dakota127/ctc/pictures/ctc2.jpg

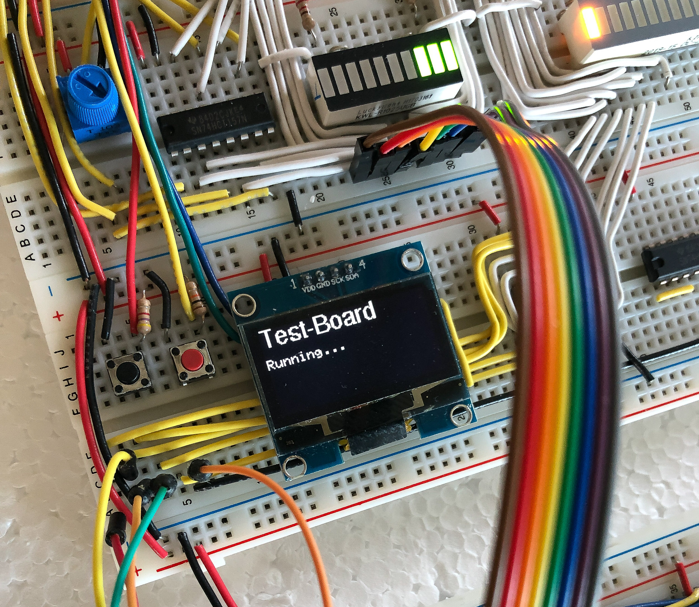
pictures/ctc2.jpg
