dakota127/ctc/pictures/ctc1.jpg

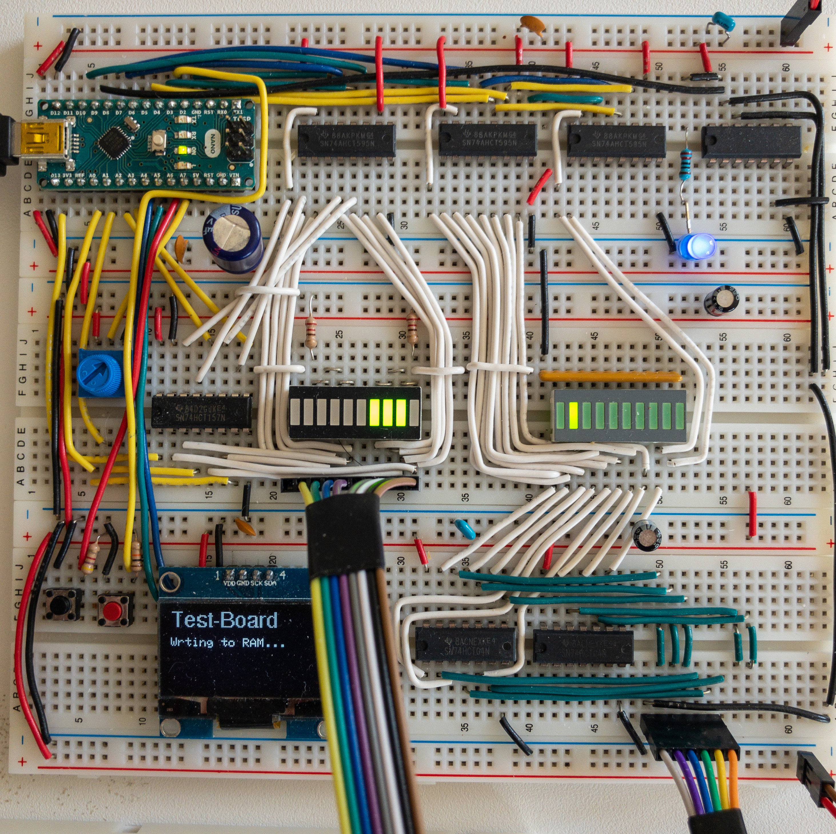
pictures/ctc1.jpg
