dakota127/ctc/README.md

# Component Tester Circuit

This documentation describes a Component Tester Circuit (CTC) that can be used to test component boards
of 8-bit breadboard computers. 
It is inspired by the works of Ben Eater and James Bates, whose videos can be found on YouTube.

Documentation and code on GitHub. 
Documentation (pdf) can be found in the docu folder.  

Free to use, modify, and distribute with proper attribution.
Frei für jedermann, vollständige Quellangabe vorausgesetzt.
