dakota127/ctc/pictures/ctc3.jpg

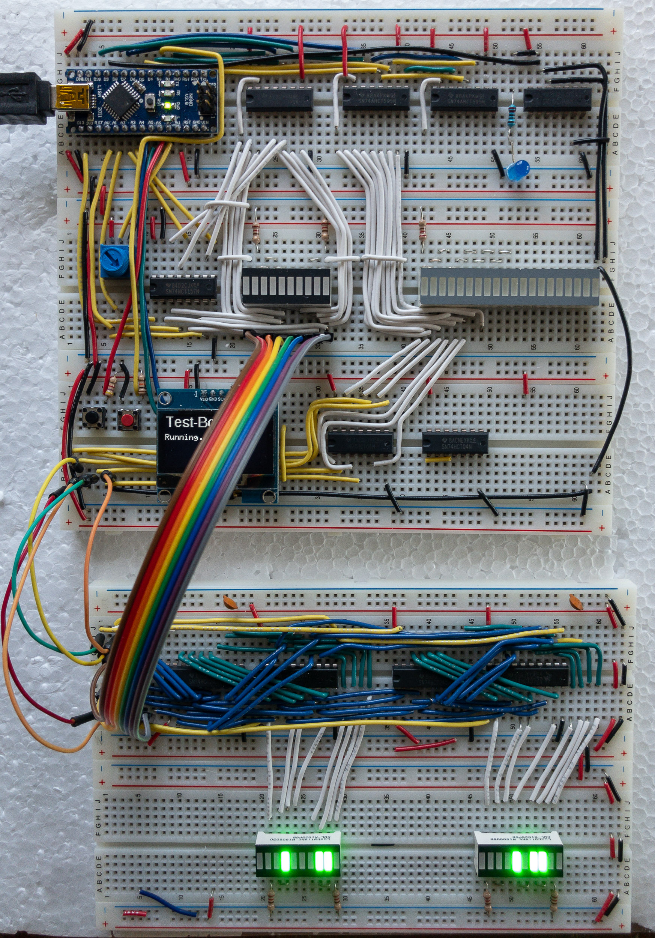
pictures/ctc3.jpg
