dakota127/ctc/pictures/ctc4.jpg

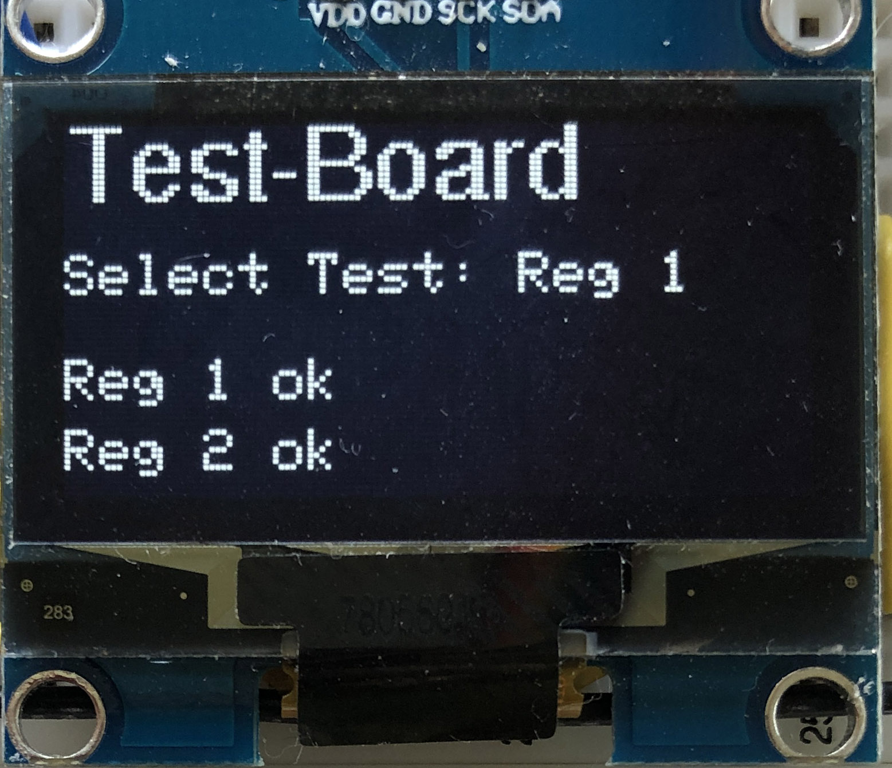
pictures/ctc4.jpg
