dakota127/ctc/pictures/Ctc-ram.jpg

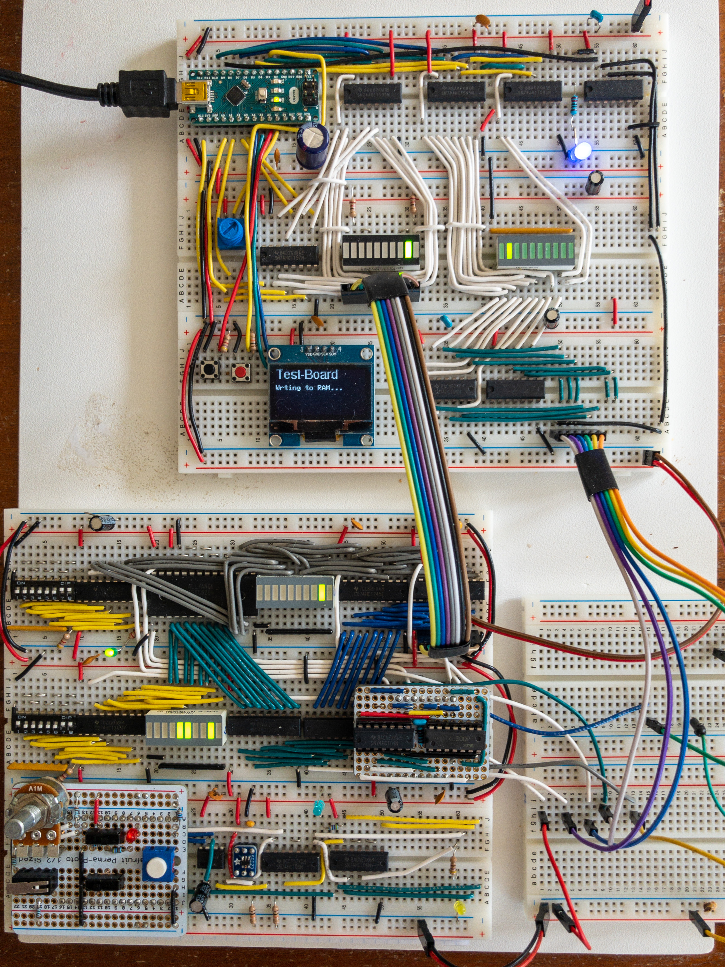
pictures/Ctc-ram.jpg
