dakota127/ctc/docu/Project-tester.pdf

# Project Description

# Component Tester Circuit

# CTC

Version 1
Peter K.B. , October 2019

This docu is part of the GitHub Project Page (https://github.com/dakota127/ctc)

### Component Tester Circuit Documentation Page 1

### Inhaltsverzeichnis

## 1. Purpose of the Component Tester Circuit

This circuit was developed to test components of my future 8-bit computer on breadboard. This computer will have components on individual breadboards. Components are: general purpose registers, an ALU, a RAM board, program- and stack-pointer boards and more.
The function test of these components will be done using this CTC.
Ben Eater‘s famous videos on YouTube have inspired others to make their own versions of a SAP computer (Simple as possible, as described by Albert Paul Malvino in his book „Digital Computer Electronics“
(c) 1977.)

For myself, I plan to follow James Bates videos, whose computer has 8-bit addresses instead of 4-bit addresses used by Ben Eater. Thanks to both for their work and excellent didactic skills in explaining their respective builds.

Manual testing of finished component boards of the 8-bit breadboard computer such as general purpose registers, memory module, ALU, etc. is tedious at best and an Arduino based circuit seems the best way to do this. The Component Tester Circuit (CTC) allows thourough testing of the individual components boards.

The finished CTC circuit looks like this:

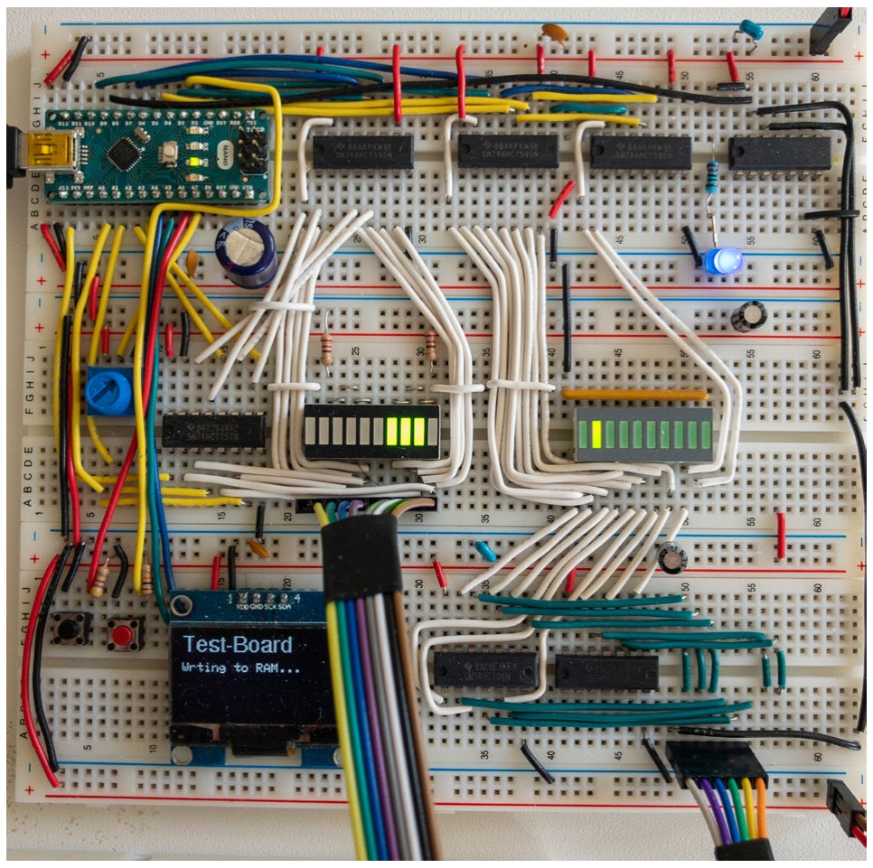
[picture p6: figure]

Component Tester on Breadbords

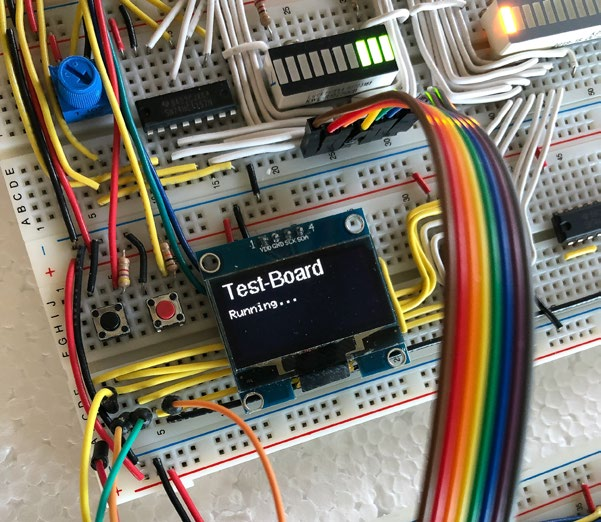
[picture p7: figure]

OLED display

## 2. How it works

The function of the CTC is simple enough: it can assert values to the 8-bit bus and it can also assert control signals and it also has a clock output. It can also read from the bus. Well, that is all that is needed to test component boards.
Of course, it also needs a user interface to select the desired test and to see the results.
The Ardunio sketch doing all this is not rocket science and one needs just one sub-function for every board to be tested. Integration tests of multiple boards (say a register board and the memory board) is also possible.
For test of a component board do this:
- connect the 8-bit bus
- connect the necessary control line (more on those later)
- select the desired test (or write a new sketch for a new component)
- start the test
- check the result on the display

## 3. Design of the CTC

The idea of the CTC was inspired by Ben Eater‘s EEPROM programer, check out his video here
Ben Eater EEPROM (https://youtu.be/K88pgWhEb1M)
The CTC uses an 8-bit bus (easily expandable to 16-bits) and supports up to 16 control lines (easily expandable to > 16 lines).
The Arduino sketch shifts out the value to be written to the bus into a shift register 74HCT595, after enabling the output, the 8-bits are asserted to the bus.
Likewise for the control signals: since 16 control signals are supported two shift register chips are needed. The control signals are connected to an led bar and hex inverters are used for the active low signals. The control signals instruct the component boards to do their thing. Another Arduino pin is used to output the clock signal.
Since the 74HCT595 chip has a 3-state output we can also read from the bus. To save Arduino pins a selector chip 74HCT157 is used. The lower 4 bits of the bus are connected to input A, the higher 4 bits to input B. With that arrangement we can read 8-bits from the bus with just 5 Arduino pins. (4 bits and one pin to select A/B input).
The user interface consists of two pushbuttons, a potentiomer (for speed control) and a 128x64 OLED display (i2c).
Pushbuttons are used as follows:
- Pushbutton 1: multiple pushes to select the desired test, this button ist connected to the A7 pin on the Arduino (adc).
- Pushbutton 2: start the selected test or cancel a running test, this button is connected to pin A3 on the Arduino, it triggers interrupt 1.

Here is what the OLED display shows after running a test of a register board with two general purpose registers:

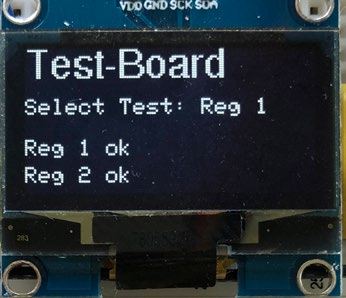
[picture p8: figure]

OLED display after running reg test

## 4. Display Output

The display shows 4 lines:
- Line 1: Titel line
- Line 2: Selection of the desired test
- Line3/4: show result of test

## 5. Schematic of the CTC

This is an overview of the CTC. Note the two pushbuttons on the left, the potentiometer on the left , the two led bars for bus and control lines and the OLED display.

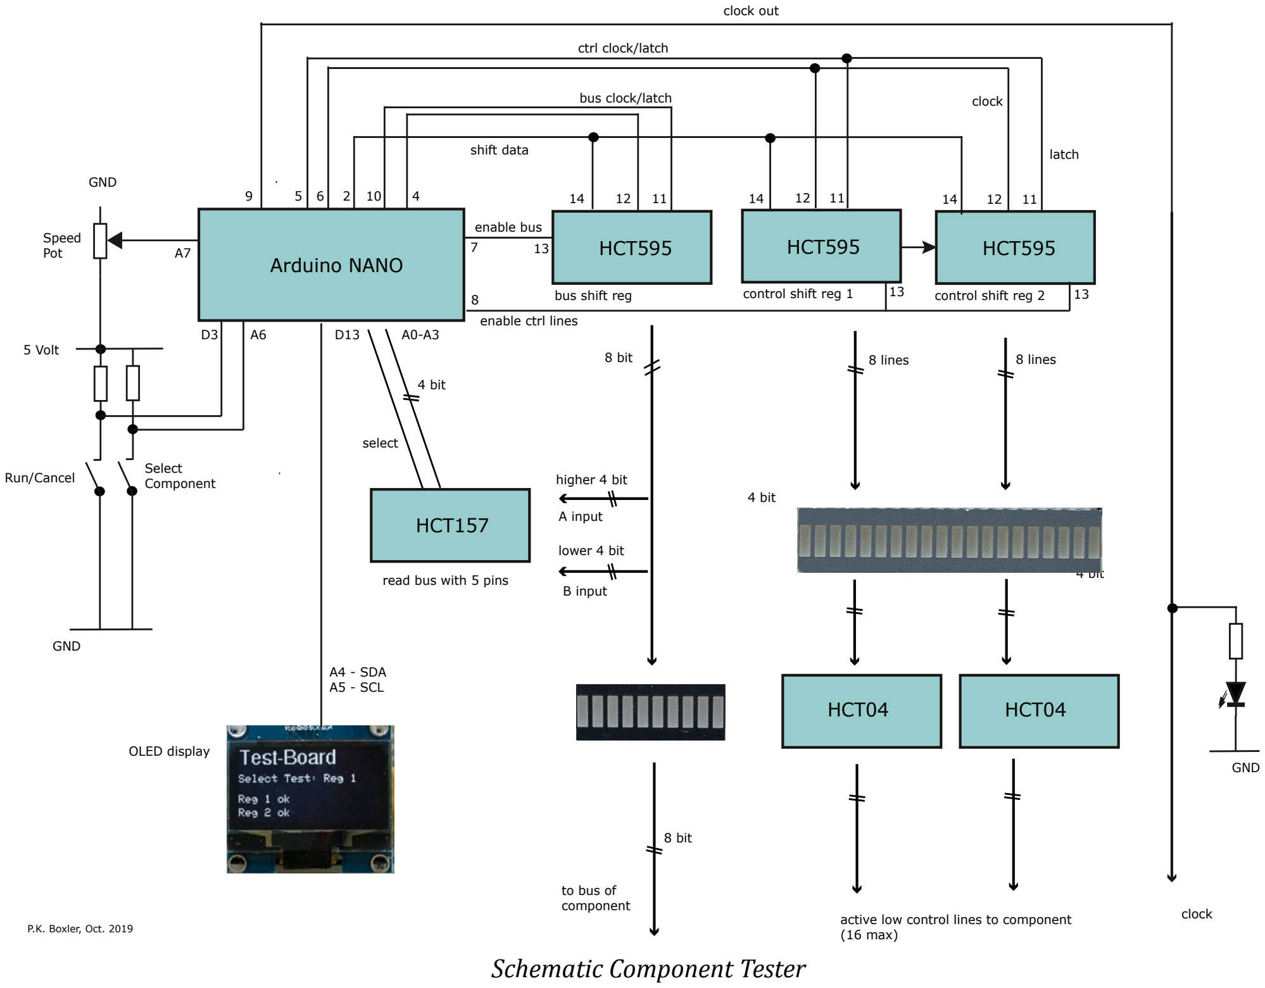
[picture p9: figure]
5 Volt; GND; Speed Pot; Select Component Run/Cancel; HCT595; Arduino NANO; HCT157; HCT04; 8 bit; 8 lines; 4 bit; select; shift data; enable bus; enable ctrl lines; bus clock/latch; ctrl clock/latch; latch; clock; bus shift reg; control shift reg 1; control shift reg 2; read bus with 5 pins; (16 max); to bus of; component; OLED display; A4 - SDA A5 - SCL; clock out; higher 4 bit; A input; lower 4 bit; B input; Schematic Component Tester

P.K. Boxler, Oct. 2019 | active low control lines to component

Test Circuit for 8-bit Computer Components

## 6. Control lines

The CTC in its current implementation supports 8 control lines. They are simply numbered 0 to 7 since their semantic depends on the board to be tested. The sketch and the connections to the board under test has to match.

## 7. Example

This pic shows the CTC hooked up to a board containing a RAM for my future 8-bit computer. Connections include the 8 bus lines, four control lines (MARW, MW, ME, PGM) and the clock line. The Arduino sketch runs a test on all 256 memory locations (write and read) and displays the result on the display (see above). After that another test (or the same) can be selected.
Check out the arduino code ram_test.ino on GitHub: (https://github.com/dakota127/ctc)
It loops over all mem locations from 0 to 255, asserts the value onto the bus, sends the control signal to write to the memory address register (MARW), pulses the clock, then, after a short delay, it asserts the data onto the bus and sends control signal MW (memory write). Data is written into the selected location. After all locations are written to the sketch reads from all memory locations and compares the data. If all values match the RAM seems to work ok.

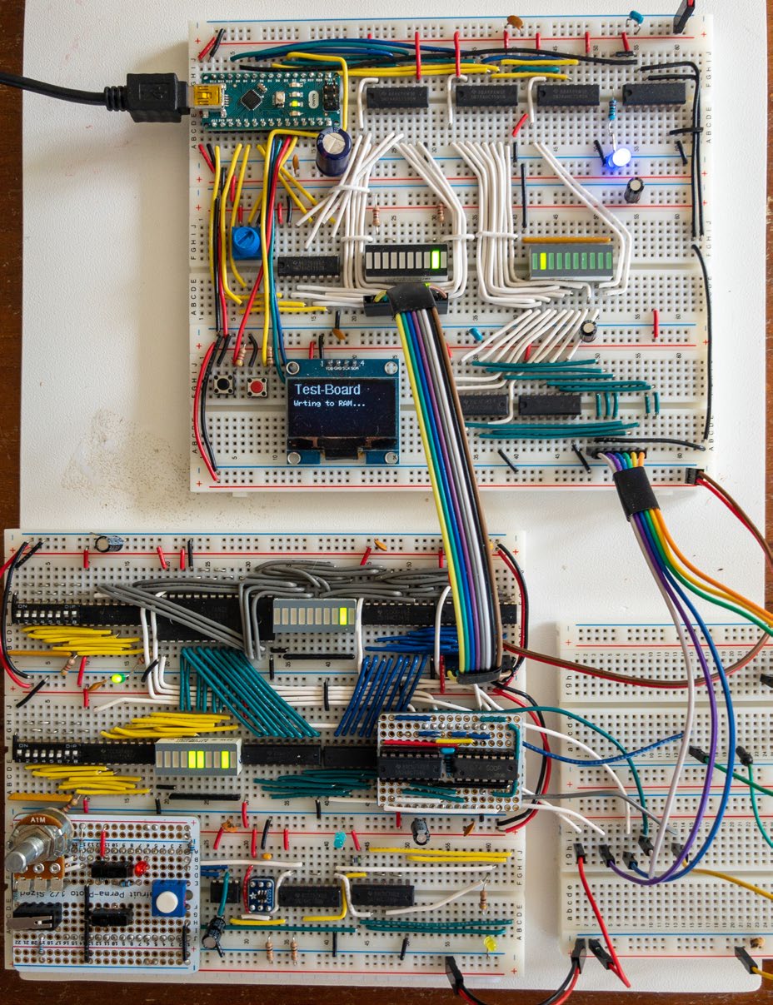
[picture p10: figure]

CTC connected to RAM board

## 8. Powersupply

At the beginning I used the 5 Volt output of the Arduino Nano to power the logic part of the board. That brought lots of strange behaviour of the cmos chips. With the help of an oscilloscop I found that the Arduino 5 Volt is unsuitable for logic circuits: to much noise.
I normally use a 5 Volt powerbank with two USB connectors to power my boards. After using one output to power the Arduino and the other output to power the rest of the circuit I had clean logic signals.

## 9. Libraries used

The Arduino sketches need the following libraries:

#include <stdint.h>

#include <Adafruit_GFX.h>

#include <Adafruit_SH1106.h>

and also the precomplier directives for debug output. Author Andreas Spiess, found here. Very useful, but can be replaced by Serial.print(). These are helpful for optimizing size of executable.

https://github.com/SensorsIot/Pre-Compiler-Directives

## 10. Conclusion

Works as designed. Easy enough. More fun than fiddling with wires and looking at leds at the same time. And: this circuit could also be used (with another sketch) to load programs into memory (once the computer is finished).

## 11. Links

My Raspberry Projecs website (http://projects.descan.com)

CTC on GitHUB (https://github.com/dakota127/ctc)

Ben Eater on YouTube (https://youtu.be/9PPrrSyubG0)
Ben Eaters website (https://eater.net/8bit/kits)
Ben Eater on reddit‘s (https://www.reddit.com/r/beneater/)

James Bates on YouTube (https://youtu.be/gqYFT6iecHw)
James Bates on GitHub (https://github.com/jamesbates/jcpu)

James Sharman on YouTube (https://youtu.be/KEwL2P8IGaA)

end of document

This page intentionally left blank (last page)
