dakota127/ctc/arduino/test_comp/alu_test.ino

//--------------------------------------------
//  ALU  Testmodule 1
//
//  The function alu_test() is called from the test_comp.ino module
//
// Nov. 2019  Peter K. Boxler
// -------------------------------------------
int alu_test() {

int error_anz = 0;   
int busValue;
int anz_error = 0;

  writeLine (4, "not impl.");
  
 return (error_anz);
    
}

//----------------------------------
